trpbabos-jpg/Tech-pioneers-/bom/datenblaetter/hc-sr04_eckdaten.jpg

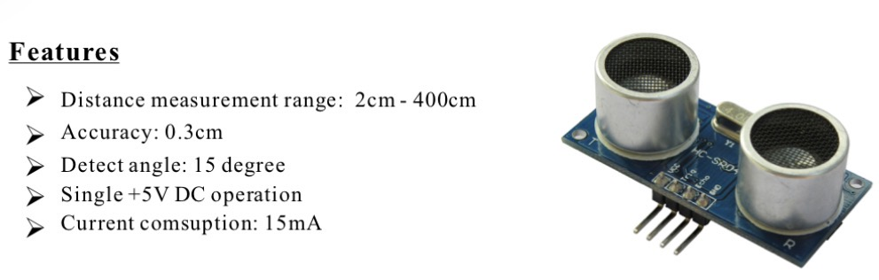
bom/datenblaetter/hc-sr04_eckdaten.jpg
