trpbabos-jpg/Tech-pioneers-/bom/datenblaetter/esp32-pico-kit-1_board.jpg

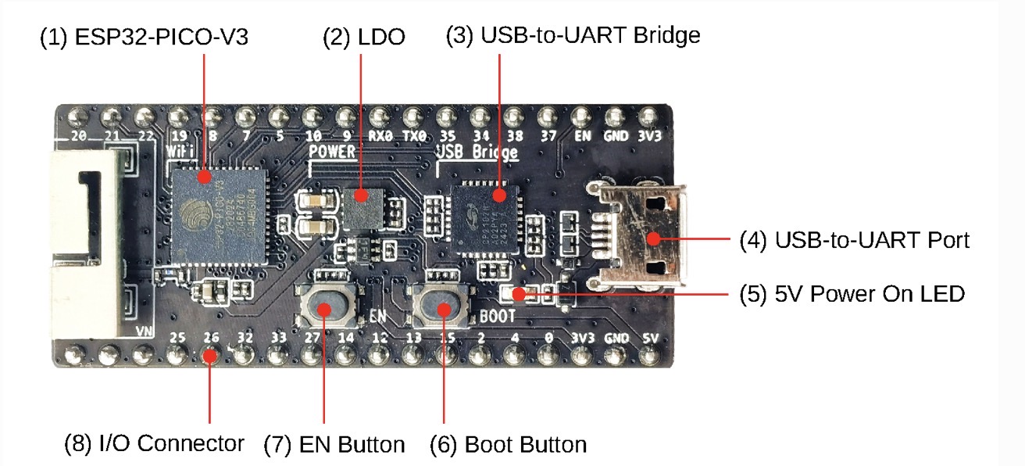
bom/datenblaetter/esp32-pico-kit-1_board.jpg
