trpbabos-jpg/Tech-pioneers-/code/README.md

# Code

MicroPython für den ESP32. Nah an den Vorlesungsfolien (Kap. 4, 4a bis 4d) 
- `main.py` ist das aktuelle Fahrprogramm, das auf dem ESP32 läuft.
- Jeder funktionierende Zwischenstand bekommt eine eigene Datei, z. B. `fahren_v5_geradeaus.py`, `fahren_v8_sanft_bremsen.py`.
