trpbabos-jpg/Tech-pioneers-/elektronik/README.md

# Elektronik

- Schaltplan (PDF oder Bild)
- Pinbelegung des ESP32 (welcher Pin ist Trigger, Echo, Motor, Encoder, Taster)

Wenn sich ein Pin ändert: Schaltplan, Pinbelegung und Code im selben Commit anpassen.

## Dateien

- `pinbelegung.md`: aktuelle Pinbelegung und frühere Stände
- `steckplan.html`: Steckplan zum Stand 29.10.2026 im Browser öffnen. Draufsicht wie auf dem Board (vorne oben), Pinübersicht und Steckliste in 8 Schritten
- `steckplan_draufsicht.png`: dieselbe Draufsicht als Bild, z. B. für Präsentationen
