trpbabos-jpg/Tech-pioneers-/doku/praesentationen/2026-11-06_weekly-closing-kw45.pdf

# Vom Frankenstein zum Batmobil

# Der Encoder hält ihn auf der Spur

Bei jedem Takt vergleicht main.py, wie viele Impulse
links und rechts gezählt wurden.

Hat links mehr, ist das linke Rad weiter gefahren. Dann bekommt links weniger Gas und rechts mehr.

Wie stark er reagiert, bestimmt KP. Bei uns sind es 0,5 % pro Impuls Unterschied.

So rechnet er

## Korrektur = 0,5 × Unterschied

Beispiel
links 110, rechts 100 Impulse
Unterschied 10 Impulse, gut 1 cm
0,5 × 10 = 5 % Korrektur
links 5 % weniger Gas, rechts 5 % mehr

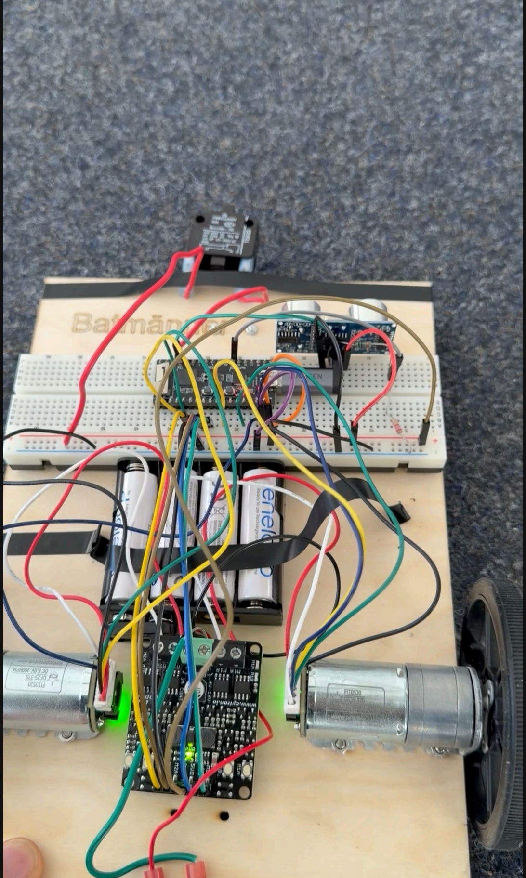
[picture p6: figure]

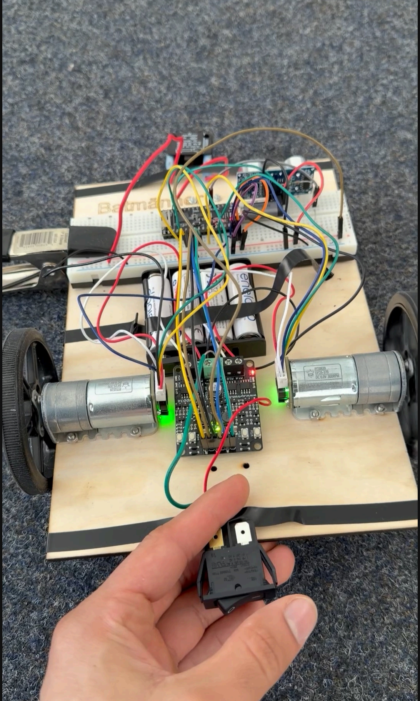
[picture p7: figure]

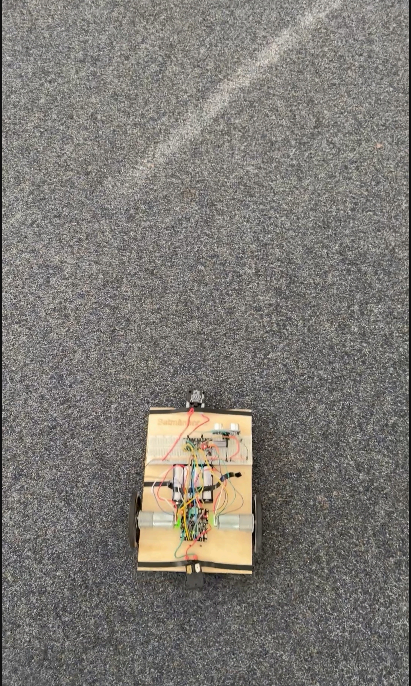
[picture p8: figure]

# Alles ausgemessen und gewogen

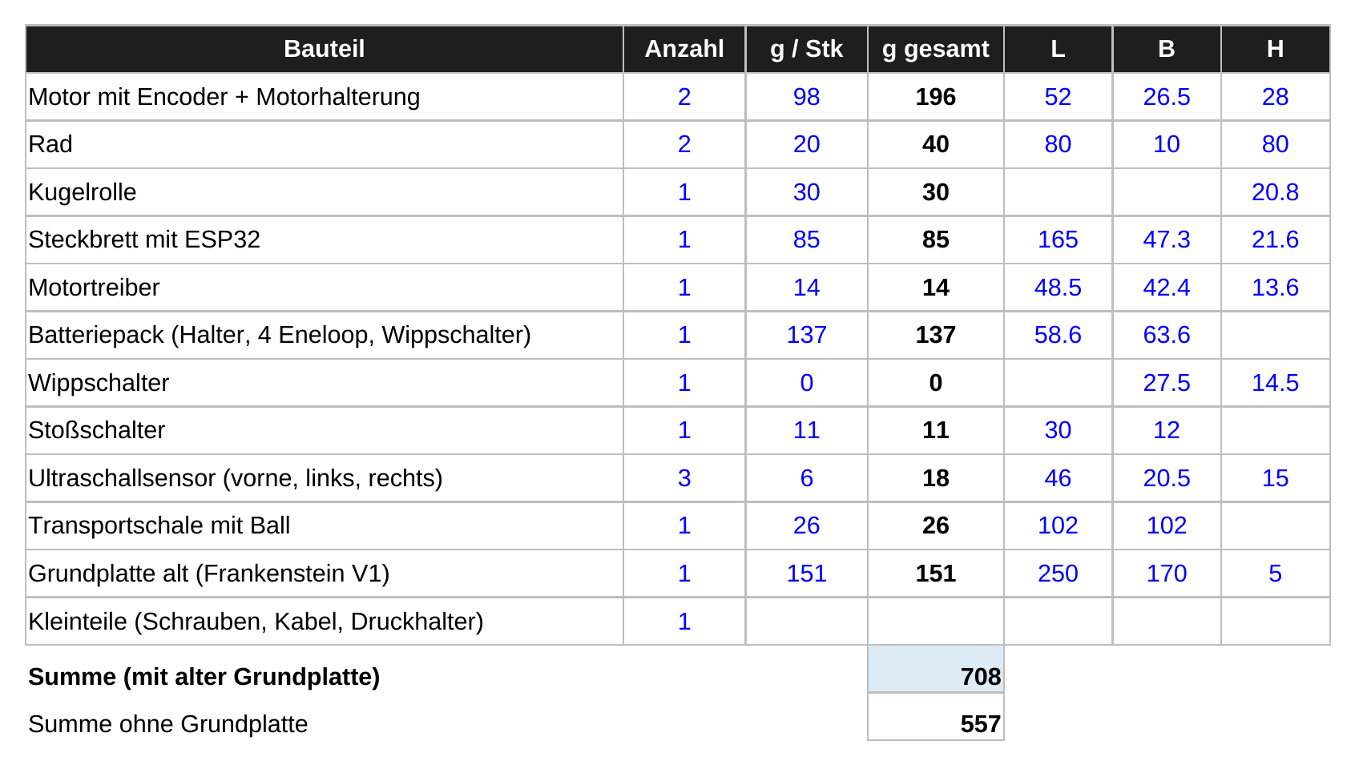
[picture p9: figure]

Ausschnitt aus unserer Excel-Tabelle, Maße in mm, Gewicht in g

Jedes Bauteil bekommt einen gedruckten Halter, der mit M3 an der Platte verschraubt wird.

Drei Ultraschallsensoren
Vorne, links und rechts, weil die Seitenwände aus Blöcken bestehen und nicht gerade sind.

# Die Schale kommt auf einen Turm

105 mm

Schalenrand über dem Boden

# 85 mm

darüber nur Podest und Schale

Um die Schale müssen 80 mm frei bleiben.

Alles andere bleibt unter 85 mm, die Räder sind 80 mm hoch.

Die Schale sitzt auf einem Turm über dem Schwerpunkt (Achse).

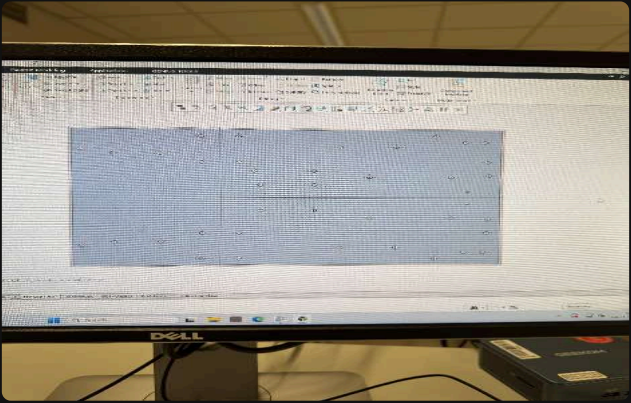
[picture p10: figure]

Caption for the image.

# Grundplatte V2

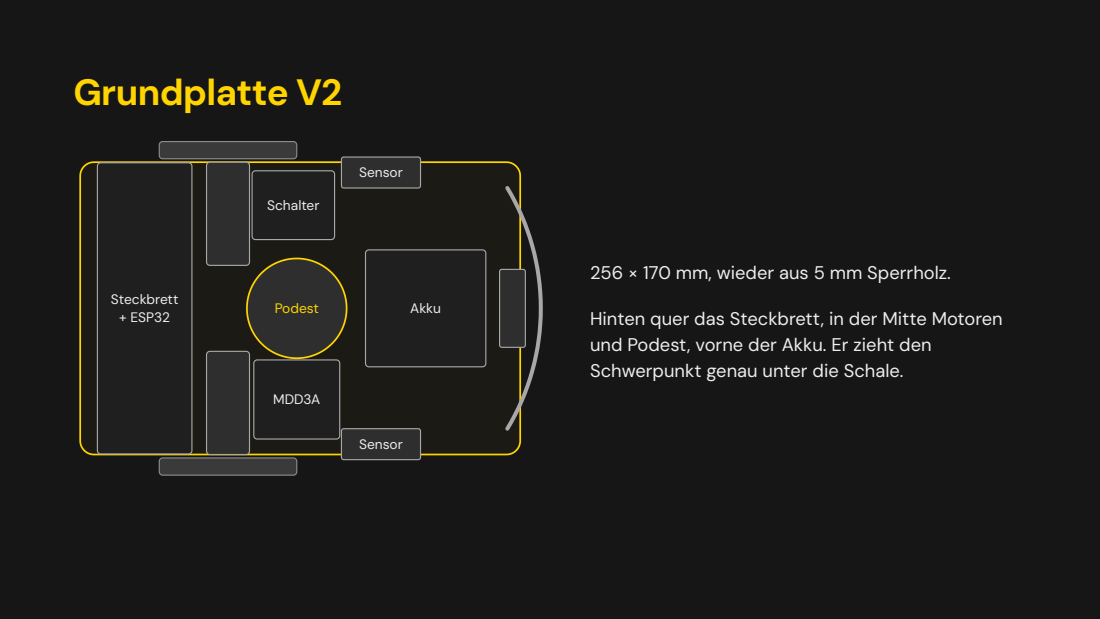
[picture p11: page 9]
Steckbrett + ESP32; Schalter; Podest; MDD3A; Akku; Sensor

256 × 170 mm, wieder aus 5 mm Sperrholz.

Hinten quer das Steckbrett, in der Mitte Motoren
und Podest, vorne der Akku. Er zieht den
Schwerpunkt genau unter die Schale.

# Aus dem Chassis wird ein Batmobil

# 85 mm

Flach und breit, so wie ein Batmobil sowieso aussieht.

Die Kapseln der Ultraschallsensoren schauen durch Löcher heraus, wie Waffen.

# Nächste Woche

## Den Ball auf dem Roboter testen sowie den Code anpassen Grundplatte V2 in Creo zu Ende zeichnen und lasern Die Komponenten auf die neue Grundplatte anbringen Kanban Board erstellen
