trpbabos-jpg/Tech-pioneers-/doku/praesentationen/2026-10-16_pitch.pdf

Study Bootcamp Technik, TechPioneers, WS 2026/27

# Mobiler Roboter für den Wall-Sprint

## Pitch: Bauteile und erste Ideen

Was er können muss
200 cm geradeaus fahren
kontrolliert und sanft vor der Wand anhalten dabei so schnell wie möglich sein

# Steuerung: ESP32-PICO-KIT-1


Chip | ESP32-PICO-V3, 2 Kerne, 240 MHz
Funk | WLAN und Bluetooth eingebaut
Versorgung | USB, 5V-Pin oder 3V3-Pin, immer nur eine Quelle
Pins | 3,3 V, höchstens 3,6 V
Nur Eingang | GPIO 34 bis 39

Quellen: Espressif, ESP32-PICO-KIT-1 User Guide; ESP32-PICO Datenblatt, Kap. 5.2 bis 5.4

# Antrieb: DFRobot FIT0520 mit Encoder

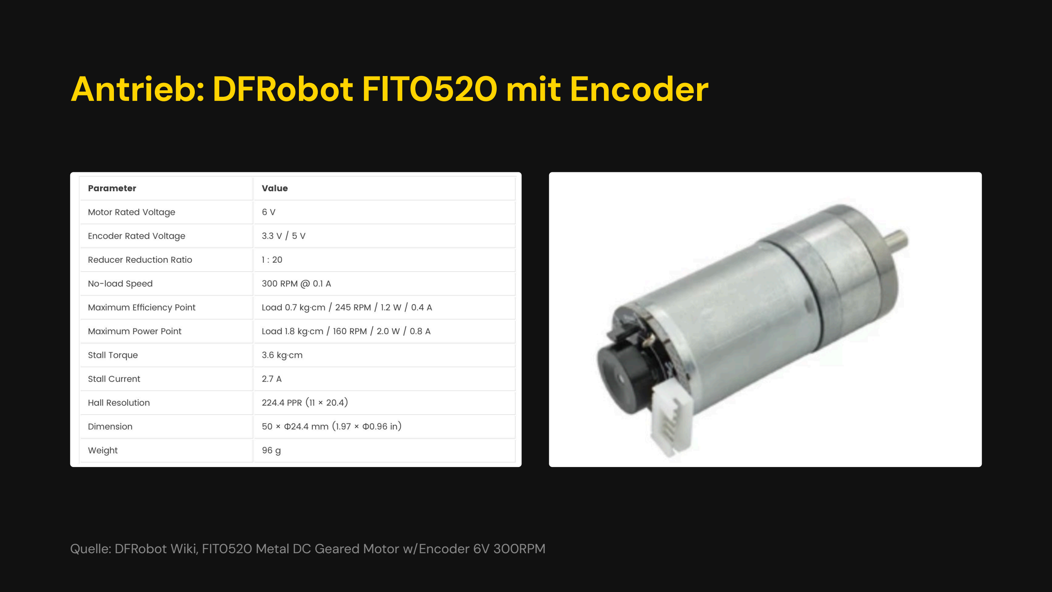
[picture p12: page 3]

Quelle: DFRobot Wiki, FIT0520 Metal DC Geared Motor w/Encoder 6V 300RPM

# Motortreiber: Cytron MDD3A

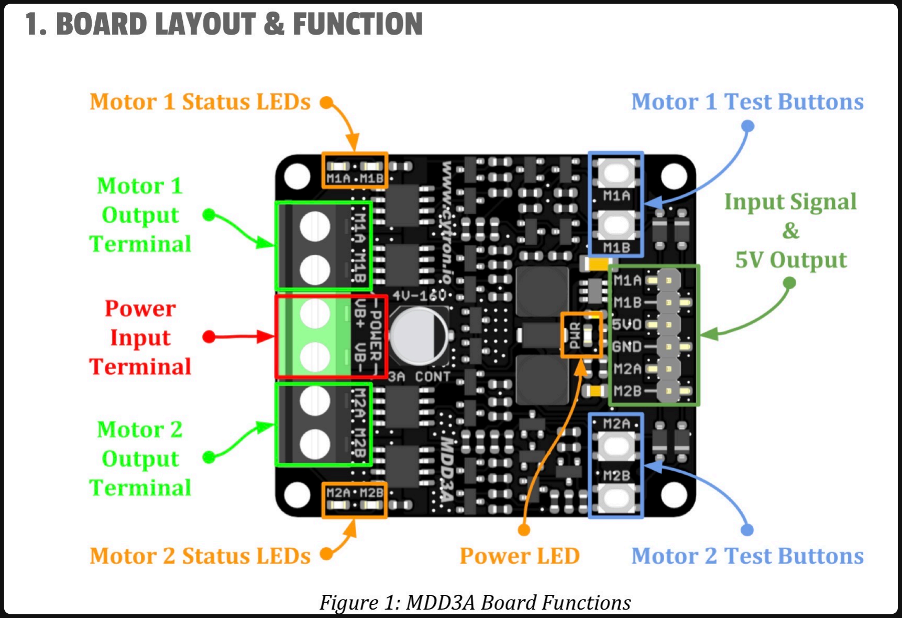
[picture p13: figure]

Spannung | 4 bis 16 V
Strom | 3 A dauerhaft, 5 A unter 5 s
Eingänge | ab 1,7 V high, 3,3 V reichen
PWM | bis 20 kHz
Bremsen | wenn beide Eingänge gleich sind
5-V-Ausgang | höchstens 200 mA
Extra | Testtaster für jeden Motor

Quelle: Cytron, MDD3A Datenblatt (Spezifikation und Wahrheitstabelle)

# Abstand: Ultraschallsensor HC-SR04

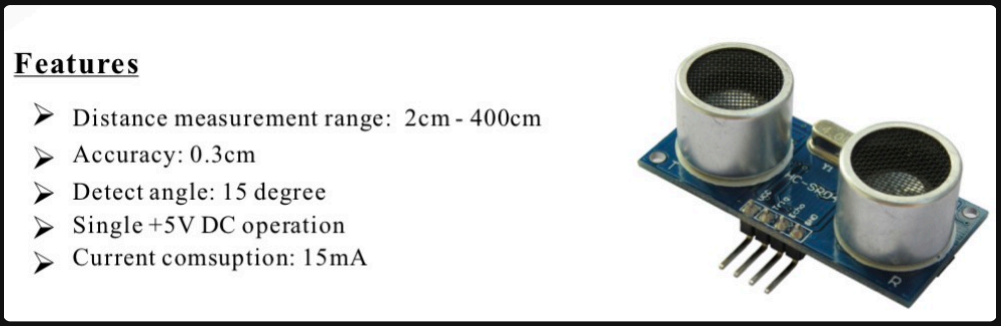
[picture p14: figure]

Quelle: HC-SR04 Datenblatt (ElecFreaks), Bilder aus dem Datenblatt

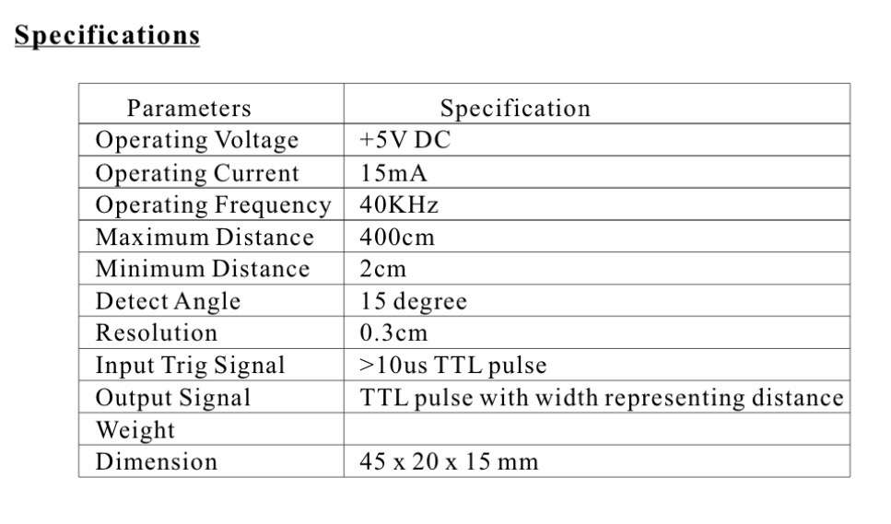
[picture p15: figure]

# Energie: 4 Eneloop-Akkus BK-3MCDE

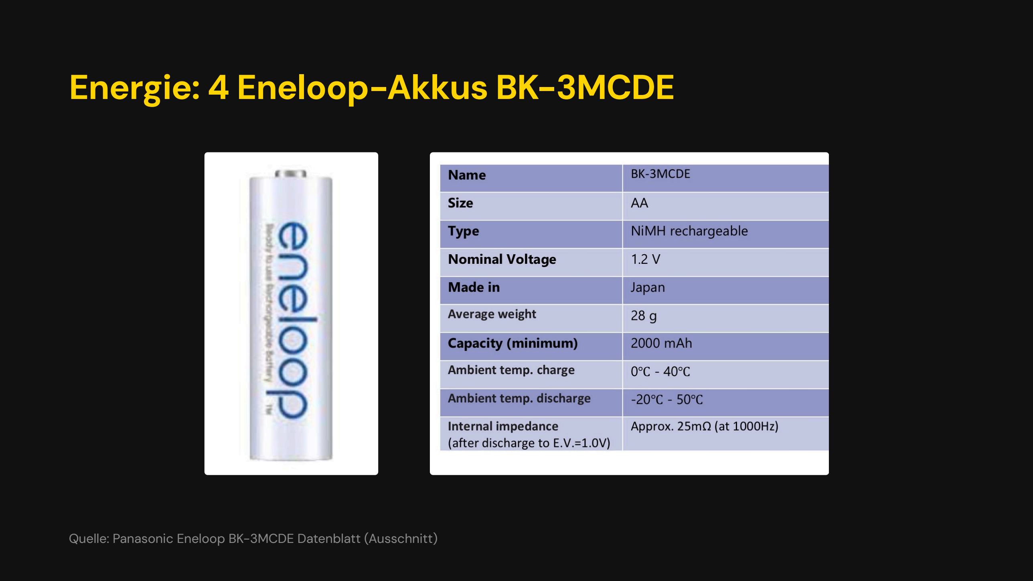
[picture p16: page 6]

Quelle: Panasonic Eneloop BK-3MCDE Datenblatt (Ausschnitt)

# Rechnungen

Was | Rechnung | Ergebnis
Drehzahl bei 4,8 V | 245 U/min × 4,8 V ÷ 6 V | ≈ 196 U/min
Radumfang | π × 80 mm | ≈ 251 mm
Geschwindigkeit | 196 ÷ 60 s × 0,251 m | ≈ 0,82 m/s
Fahrzeit bei vollem Tempo | 2,0 m ÷ 0,82 m/s | ≈ 2,4 s

Werte aus den Datenblättern: DFRobot FIT0520 (245 U/min bei 6 V, 224,4 Impulse) und Eneloop BK-3MCDE (1,2 V pro Zelle)

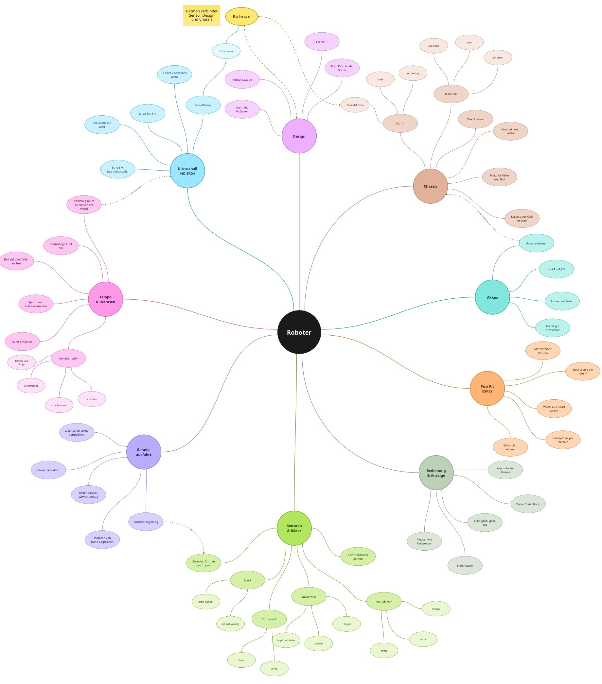
[picture p17: figure]

# Mind Map

Ast
Querverbindung zwischen zwei Ästen

Wichtige Querverbindungen
Bremsbeginn → Ultraschall: erkennt die Wand Encoder-Regelung → Encoder: nutzt die Impulse Akkus unten → Chassis: tiefer Schwerpunkt Batman → Design und Chassis

# Warum der Name Batman

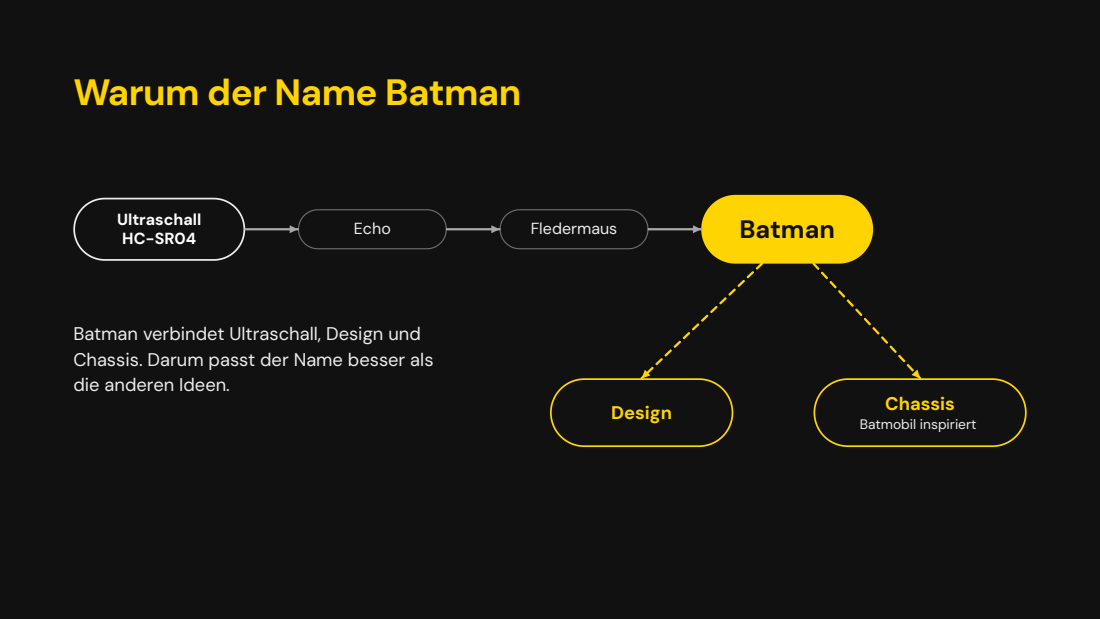
[picture p18: page 9]
Ultraschall HC-SR04; Echo; Fledermaus; Batman; Design; Chassis Batmobil inspiriert

Batman verbindet Ultraschall, Design und
Chassis. Darum passt der Name besser als
die anderen Ideen.

# Offene Fragen

Frage | Ideen aus der Mind Map
Geradeausfahrt | Encoder-Regelung,, zwei Sensoren vorne vergleichen, Ultraschall seitlich mit Bande als Hilfe
Anhalten | aktiv bremsen, Rollen
Wand erkennen | ein oder zwei Ultraschallsensoren vorne, Strecke über die Encoder zählen
Antrieb und Stütze | Antrieb vorne, hinten oder mittig, eine Kugel, zwei Roller oder beides
Chassis | rund oder rechteckig, Sperrholz, Acryl oder 3D-Druck
Bedienung | Taster Start/Stopp, LEDs, Piepser, Start per Handy über WLAN
Name und Look | Batman
