trpbabos-jpg/Tech-pioneers-/fotos/README.md

# Fotos

Fotos vom Aufbau nach jedem wichtigen Schritt und von Tests. Dateiname mit Datum, z. B. `2026-11-12_grundplatte_v2_montiert.jpg`.

Zusammengehörige Bilder kommen in einen Unterordner mit Datum und Thema, z. B. `2026-11-13_cad_baugruppe/` für die Screenshots der Creo-Baugruppe.
