trpbabos-jpg/Tech-pioneers-/doku/mindmap_v1.pdf

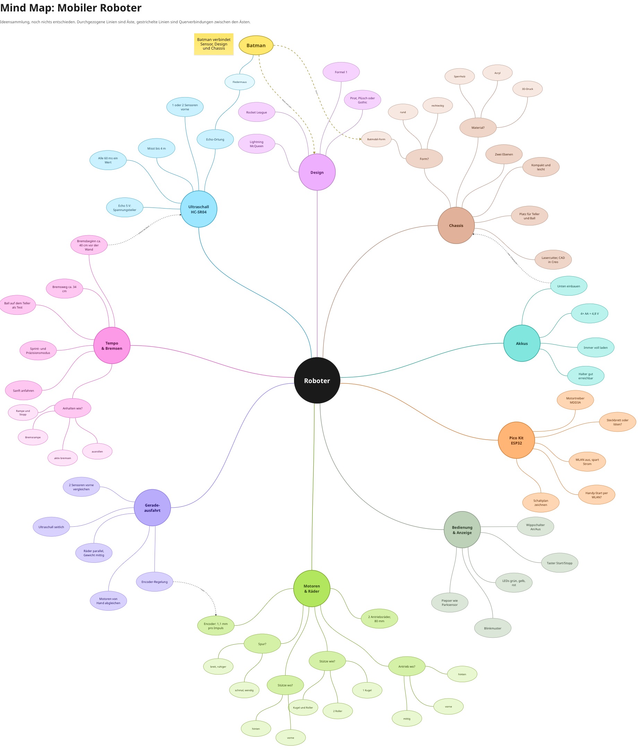
[picture p19: page 1]
