trpbabos-jpg/Tech-pioneers-/cad/skizzen/2026-10-16_echo_form_draufsicht.png

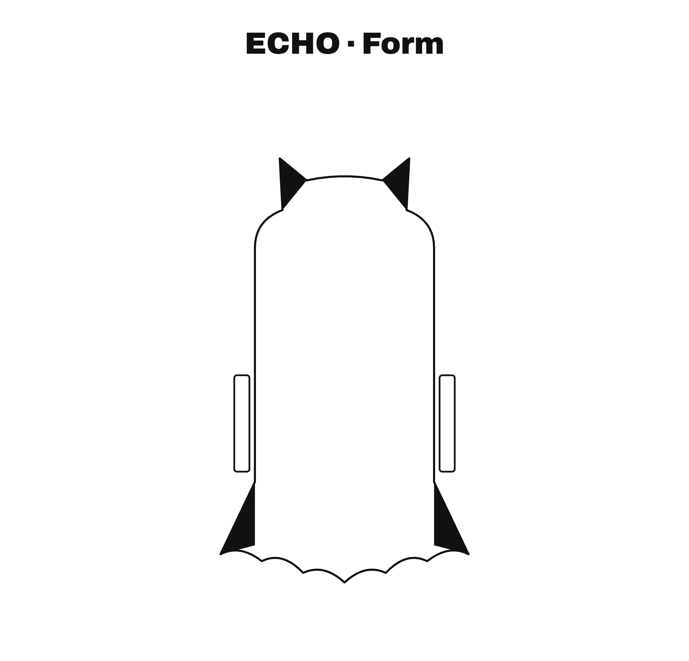
cad/skizzen/2026-10-16_echo_form_draufsicht.png
