trpbabos-jpg/Tech-pioneers-/cad/skizzen/2026-11-11_podest_schnitt.png

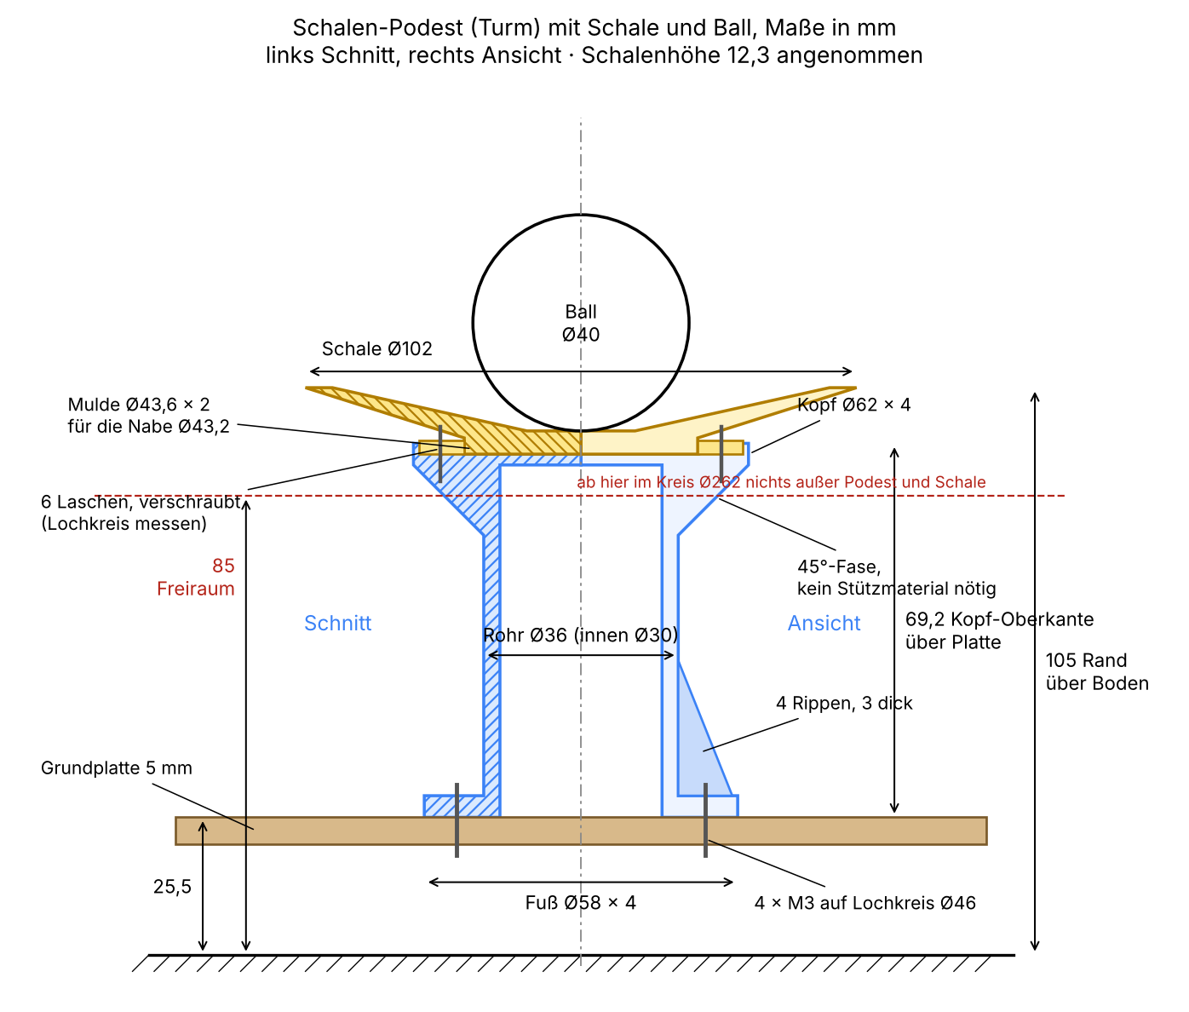
cad/skizzen/2026-11-11_podest_schnitt.png
