trpbabos-jpg/Tech-pioneers-/elektronik/steckplan_draufsicht.png

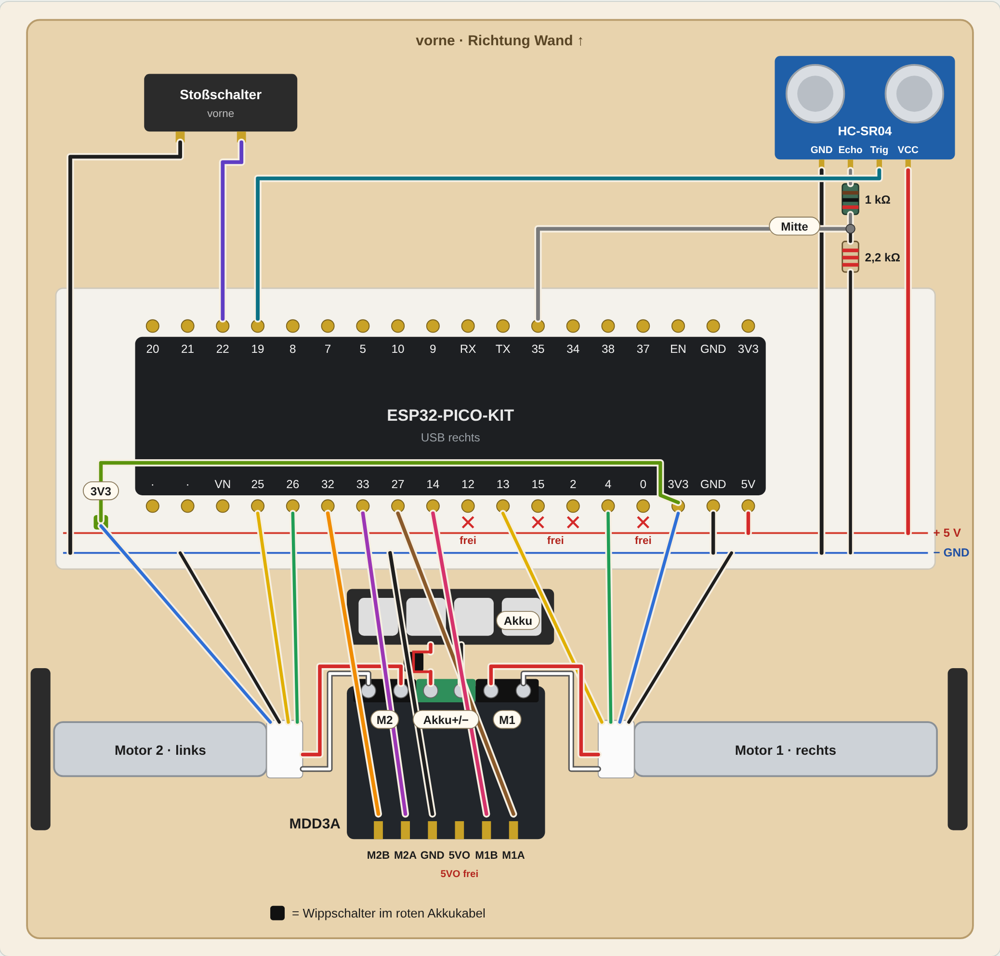
elektronik/steckplan_draufsicht.png
