trpbabos-jpg/Tech-pioneers-/fotos/2026-11-09_grundplatte_v2_draufsicht.jpg

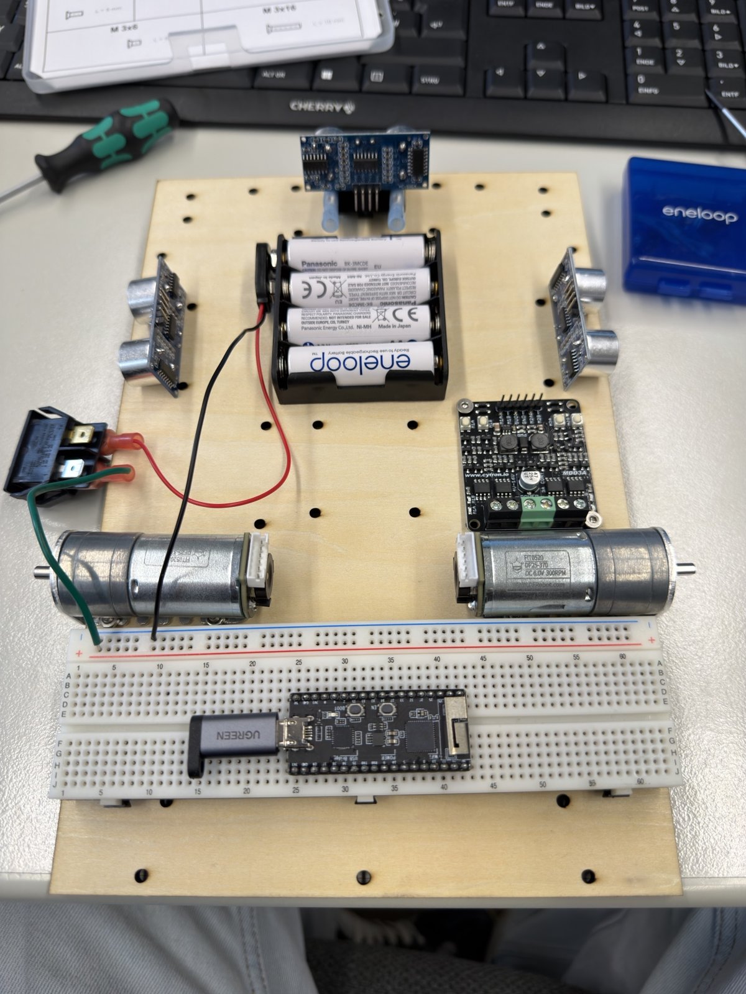
fotos/2026-11-09_grundplatte_v2_draufsicht.jpg
