trpbabos-jpg/Tech-pioneers-/fotos/2026-11-09_stossschalter_kippt.jpg

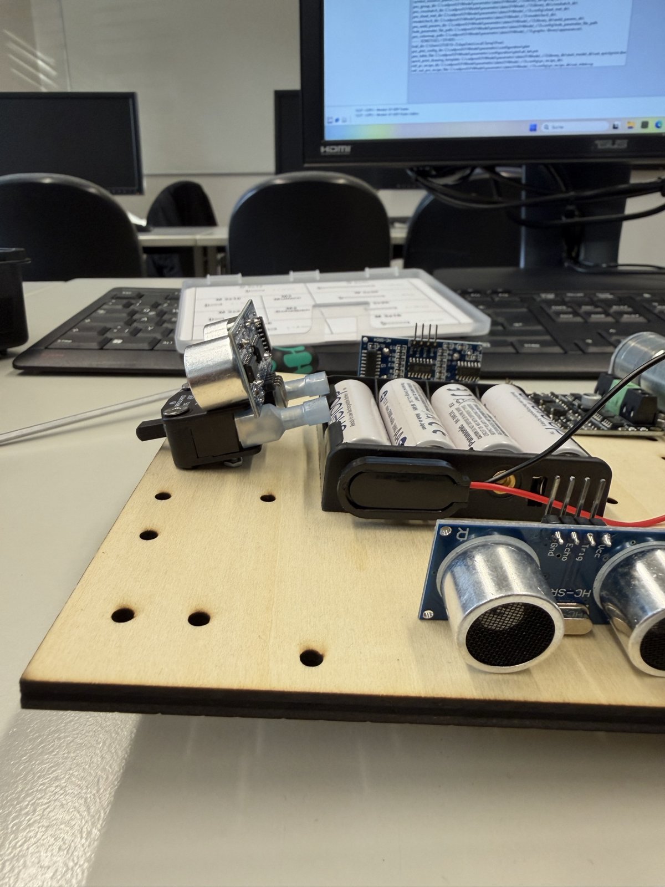
fotos/2026-11-09_stossschalter_kippt.jpg
