trpbabos-jpg/Tech-pioneers-/fotos/2026-11-09_stossschalter_unterlegt.jpg

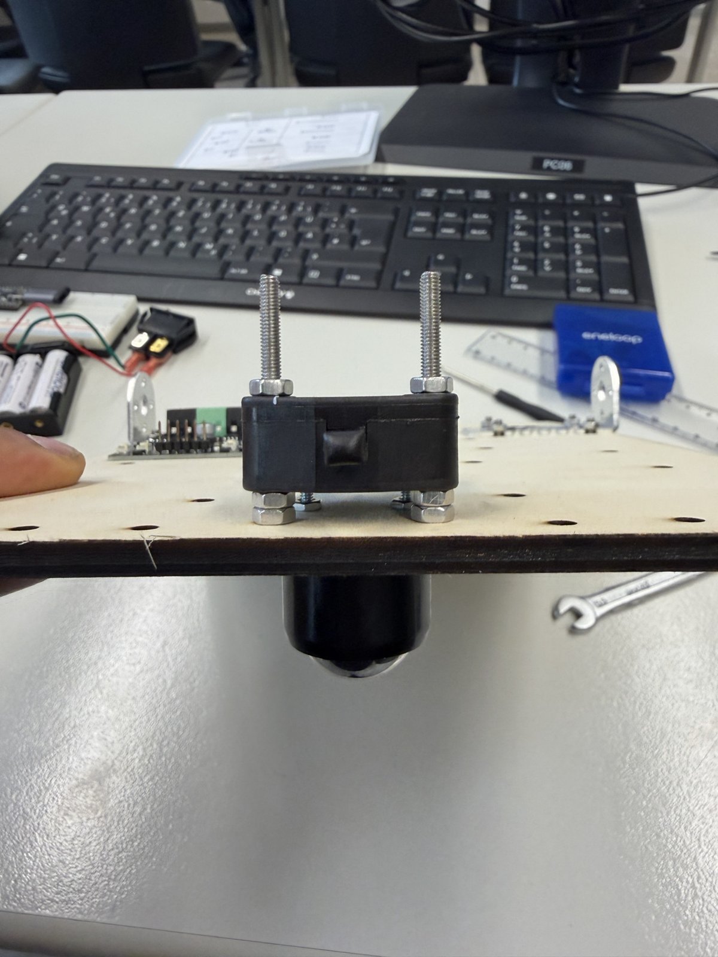
fotos/2026-11-09_stossschalter_unterlegt.jpg
