trpbabos-jpg/Tech-pioneers-/fotos/2026-11-13_cad_baugruppe/baugruppe_schraeg_links.png

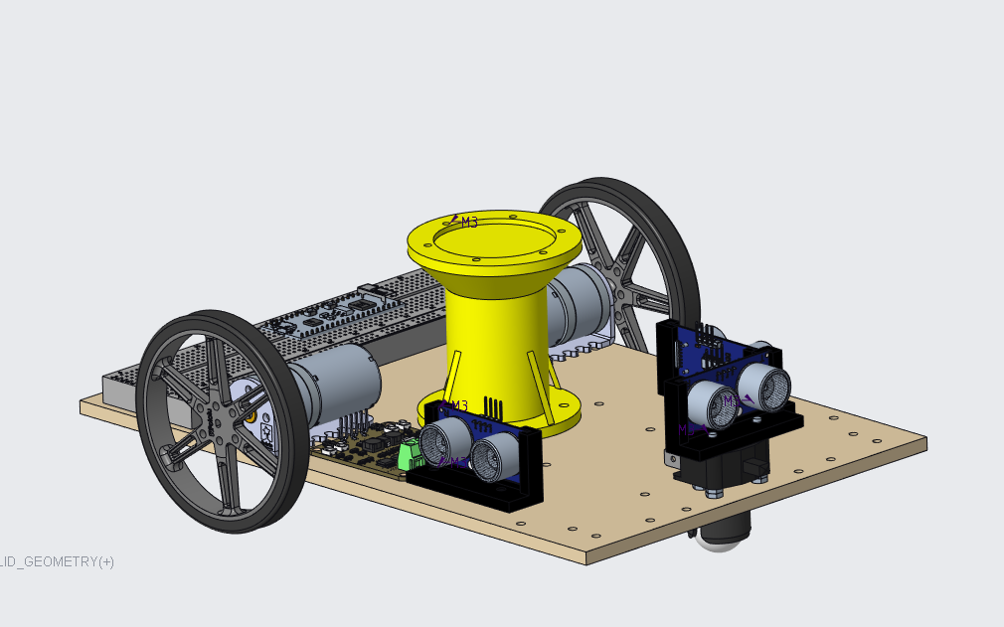
fotos/2026-11-13_cad_baugruppe/baugruppe_schraeg_links.png
