trpbabos-jpg/Tech-pioneers-/fotos/2026-11-13_elektronik_verkabelt.jpg

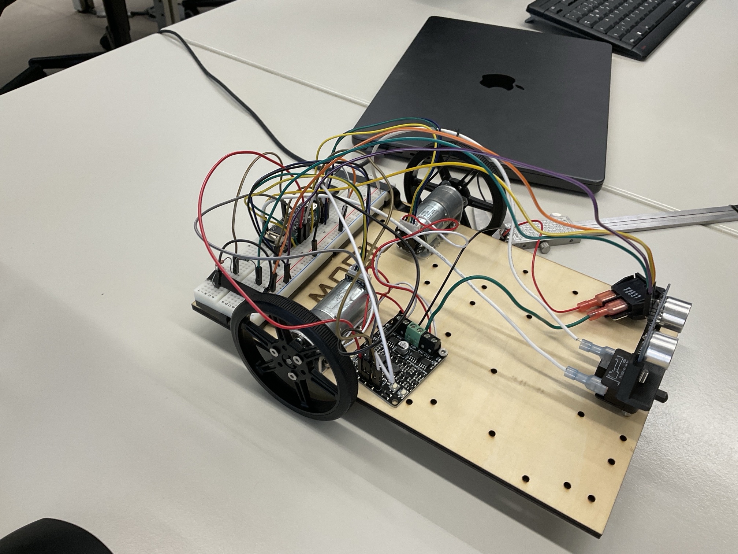
fotos/2026-11-13_elektronik_verkabelt.jpg
