trpbabos-jpg/Tech-pioneers-/fotos/starterkit_inhalt_seite1.jpg

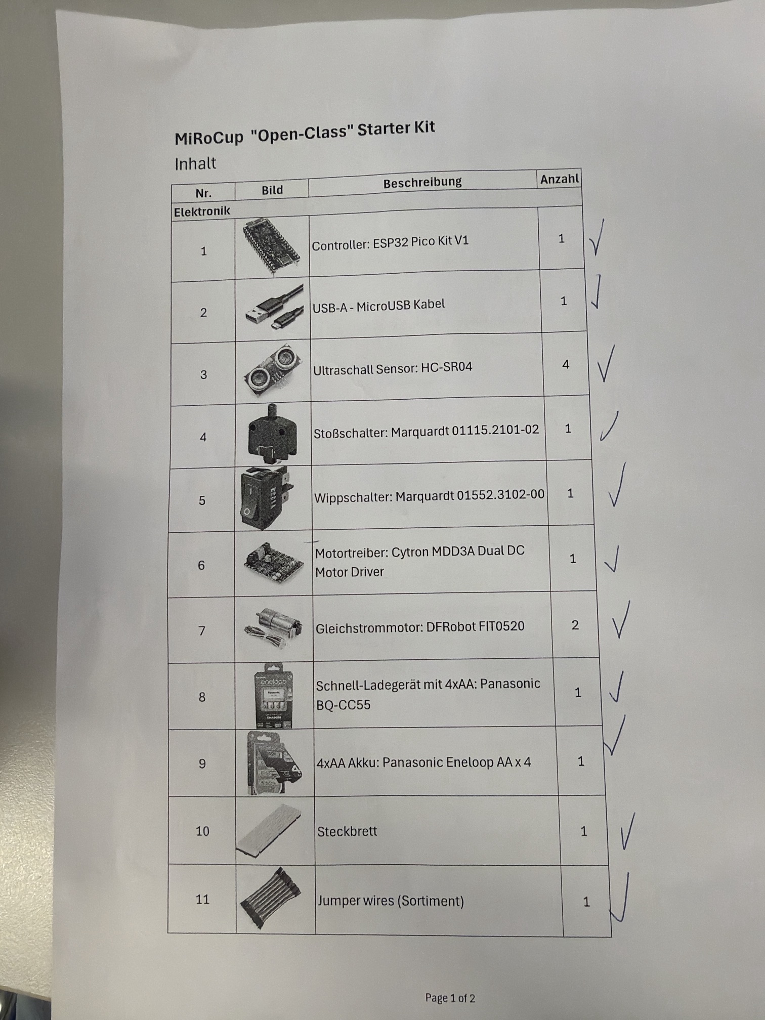
fotos/starterkit_inhalt_seite1.jpg
