trpbabos-jpg/Tech-pioneers-/fotos/starterkit_inhalt_seite2.jpg

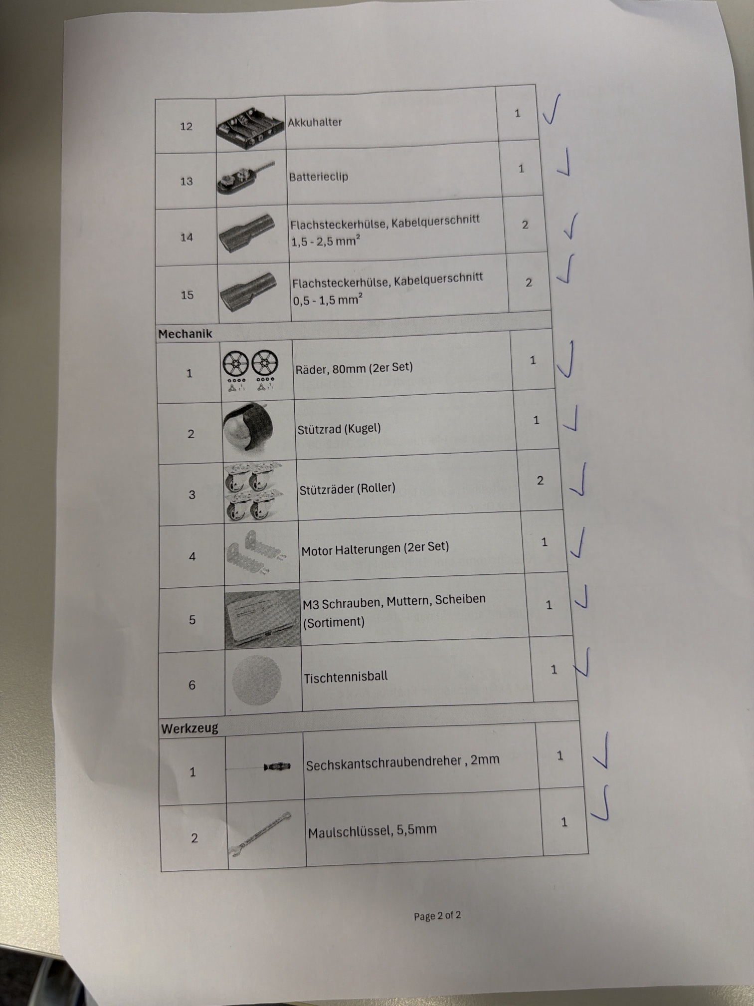
fotos/starterkit_inhalt_seite2.jpg
