trpbabos-jpg/Tech-pioneers-/bom/materialliste.md

# Materialliste (BOM)

Alle Bauteile des Roboters. „Anzahl im Kit“ ist der Inhalt des MiRoCup Starter Kits (Fotos in `fotos/starterkit_inhalt_seite1.jpg` und `seite2.jpg`), „Verbaut“ ist das, was am Roboter sitzt. Ein ? heißt: noch zählen und eintragen.

| Bauteil | Anzahl im Kit | Verbaut | Herkunft | Bemerkung |
| --- | --- | --- | --- | --- |
| Controller ESP32-PICO-KIT V1 | 1 | 1 | Starter Kit | Chip ESP32-PICO-V3, GPIO18 und 23 nicht herausgeführt |
| USB-A auf Micro-USB Kabel | 1 | 0 | Starter Kit | nur zum Programmieren |
| Ultraschallsensor HC-SR04 | 4 | 3 | Starter Kit | vorne, links, rechts, Echo jeweils über Spannungsteiler 1 kOhm / 2,2 kOhm |
| Stoßschalter Marquardt 01115.2101-02 | 1 | 1 | Starter Kit | vorne, erkennt die Wand |
| Wippschalter Marquardt 01552.3102-00 | 1 | 1 | Starter Kit | Hauptschalter zwischen Akku und MDD3A, gleichzeitig Start |
| Motortreiber Cytron MDD3A | 1 | 1 | Starter Kit | 4 x M3 mit Abstandshülsen 5 mm direkt auf der Platte |
| Gleichstrommotor DFRobot FIT0520 mit Encoder | 2 | 2 | Starter Kit | 224 Impulse pro Radumdrehung |
| Schnell-Ladegerät Panasonic BQ-CC55 | 1 | 0 | Starter Kit |  |
| Akku Panasonic Eneloop AA | 4 | 4 | Starter Kit | zusammen ca. 4,8 V |
| Steckbrett | 1 | 1 | Starter Kit | in gedruckter Wanne hinten |
| Jumperkabel (Sortiment) | 1 | ? | Starter Kit |  |
| Akkuhalter | 1 | 1 | Starter Kit | vorne als Trimmgewicht |
| Batterieclip | 1 | 1 | Starter Kit |  |
| Flachsteckerhülse 1,5 bis 2,5 mm² | 2 | ? | Starter Kit |  |
| Flachsteckerhülse 0,5 bis 1,5 mm² | 2 | ? | Starter Kit |  |
| Räder 80 mm (2er Set) | 1 | 1 | Starter Kit |  |
| Stützrad (Kugel) | 1 | 1 | Starter Kit | vorne, 2 x M2 |
| Stützräder (Roller) | 2 | 0 | Starter Kit | nicht verwendet |
| Motorhalterungen (2er Set) | 1 | 1 | Starter Kit |  |
| M3 Schrauben, Muttern, Scheiben (Sortiment) | 1 | ? | Starter Kit | Stückzahlen eintragen |
| Tischtennisball | 1 | 1 | Starter Kit | liegt in der Schale |
| Widerstand 1 kOhm |  | 3 | Labor | Spannungsteiler oben, einer pro Ultraschallsensor |
| Widerstand 2,2 kOhm |  | 3 | Labor | Spannungsteiler unten, einer pro Ultraschallsensor |
| Sperrholzplatte 5 mm |  | 1 | Labor | 256 x 170 mm, gelasert |
| 3D-Druckteile (Podest, Haube, Steckbrett-Wanne, Halterungen) |  | ? | 3D-Drucker | STL im Ordner cad |
| Gewindeeinsatz M3 |  | 7 | zusätzlich | für die Haube |
| Abstandshülse M3 5 mm |  | 4 | zusätzlich | für den MDD3A |
| Schraube M2 |  | 2 | zusätzlich | Stützrad |
| Schale für den Ball |  | 1 | ? | Ø 102 mm, Herkunft prüfen |

Maße, Gewichte und Lage der Bauteile auf der Grundplatte v2 stehen in `Grundplatte_Masse_Gewicht_V2.xlsx`.
