trpbabos-jpg/Tech-pioneers-/bom/Grundplatte_Masse_Gewicht_V2.xlsx

Sheet: Bauteile
Neue Grundplatte: Bauteile, Maße, Gewicht
Maße in mm, Gewicht in g. Blau = eingetragener Wert, schwarz = Formel. L = in Fahrtrichtung bzw. lange Seite.
Bauteil | Modell | Anzahl | g / Stk | g gesamt | L | B | H | Befestigung / Lochbild | Quelle und Abgleich | Status | Noch messen
Motor mit Encoder + Motorhalterung | DFRobot FIT0520 + Pololu #2676 | 2 | 98 | 196 | 52 | 26.5 | 28 | Winkel an den Randkerben, M3. Kerbenraster 6,35, Abstand der Kerbreihen 21,7. Achse 14,5 über Winkelunterseite. | Gewogen 90 + 8 g (online 96 + 8,5 g). Winkel gemessen 25,3 breit, Flansch 26,6 hoch (Pololu 25 und 27). Motor Ø24,4, mit Winkel ca. 1 bis 2 mm größer. | gemessen + online | Wo Encoder und Kabel hinten herausstehen (Länge gesamt).
Rad | Pololu Multi-Hub 80 × 10 mm (#3690) | 2 | 20 | 40 | 80 | 10 | 80 | Klemmhülse 4 mm D, 3 × M3 × 7. Hülse + Platte ca. 6 mm dick. | Gewogen 20 g (Pololu 23 g). Ø80, Reifen 10 mm laut Pololu. | gemessen + online | Breite über die Nabe, Spurweite am Roboter.
Kugelrolle | Pololu #955, 3/4″ Metallkugel | 1 | 30 | 30 |  |  | 20.8 | 2 Schrauben #2 oder M2 (keine M3), Lochabstand 15,5, Bohrung 2,5, ohne Spacer. Bei V1 mittig bei Y 224. | An der V1-Platte (Zeichnung V1.2) verbaut und passt. Gewogen 30 g = Pololu 30 g. Höhe 20,8 ohne Spacer laut Pololu. | gemessen + online
Steckbrett mit ESP32 | 830er, eine Stromschiene abgenommen, schwarze Bodenplatte mit Füßen | 1 | 85 | 85 | 165 | 47.3 | 21.6 | 3D-Druckhalter. Achtung: An einer Längsseite stehen 3 Nasen (Schwalbenschwanz) ca. 2 mm über, an der kurzen Seite eine kleine schwarze Nase. Im Halter dort Aussparungen oder 3 mm Luft lassen. Der USB-Adapter liegt auf dem Steckbrett, über dem ESP32 also Platz nach oben lassen. | Länge 165 (Normmaß 165,1). Breite 47,3 ohne Nasen, Höhe 21,6 mit Messschieber (Oberkante bis Füße). ESP32 52 × 20,3 laut Espressif. | gemessen + online | Wie weit die Nasen genau überstehen und wo sie sitzen (Abstand von der Ecke).
Motortreiber | Cytron MDD3A | 1 | 14 | 14 | 48.5 | 42.4 | 13.6 | 4 × M3 auf 3D-Druck-Abstandshaltern. Lochabstand quer ca. 37 (Messschieber 40 über Außenkanten minus Loch-Ø), längs ca. 42 (nur aus Foto). | Gewogen 14 g = online 14 g. Gemessen 48,5 × 42,4, online 48 × 42. Höhe 13,6 online. Lochbild steht online nur als Bild. | gemessen + online | Lochabstand längs und Loch-Ø mit Messschieber, Höhe der Lötstellen unten.
Batteriepack (Halter, 4 Eneloop, Wippschalter) | 4 × AA nebeneinander | 1 | 137 | 137 | 58.6 | 63.6 |  | 3D-Druckhalter. Mit Batterie-Clip 65,3 lang. Kabel kommt am Clip heraus. | Gemessen 63,6 × 58,6. Passt zu 4 × Ø14,5 (Eneloop) plus Wände. Gewogen 137 g, online wären allein die Akkus 4 × 27 = 108 g. | gemessen + online | Höhe.
Wippschalter | Marquardt 1552 | 1 | 0 | 0 |  | 27.5 | 14.5 | Ausschnitt 27,2 × 12,2 in einer Wand von 0,8 bis 5 mm (Druckteil). | Rahmen gemessen ca. 27,5 × 14,5, online Ausschnitt 27,2 × 12,2. Gewicht steckt im Batteriepack. | gemessen + online
Stoßschalter | Marquardt 1115 | 1 | 11 | 11 | 30 | 12 |  | 2 × M3, Lochabstand ca. 22,2 (25,4 über Außenkanten minus Loch-Ø 3,1). | Gemessen ca. 30 breit mit Laschen, ca. 12 dick. 22,2 ist das Normmaß für Standard-Mikroschalter. | gemessen + online
Ultraschallsensor (vorne, links, rechts) | HC-SR04 | 3 | 6 | 18 | 46 | 20.5 | 15 | 4 Eckbohrungen ca. Ø1,5 im Abstand ca. 42 × 17 (aus Foto): zu klein für M3. Halter mit Druckstiften Ø1,3 oder Schrauben M1,4; Halter selbst mit M3 auf die Platte. Stiftleiste ragt 6,8 seitlich über, mit Stecker mehr Platz lassen. Seitensensoren tief, Mitte 4 bis 6 cm über Boden. | Gemessen 46 × 20,5, mit Stiften 26,8. Höhe Kapsel bis Unterseite der blauen Platine 15,2, bis zu den Metallstiften hinten 17,5 (Datenblatt 45 × 20 × 15). Kapsel steht also ca. 13,6 über der Platine (Platine ca. 1,6 dick). Über beide Kapseln außen 42,1, Kapsel-Ø ca. 16 (üblicher Wert), also Kapselmitten ca. 26 auseinander. Loch-Ø ca. 1,5. Gewogen 6 g. | gemessen + online | Kapsel-Ø einmal direkt messen, falls der Halter eng sitzen soll.
Transportschale mit Ball | vom Veranstalter, Ball 40 mm | 1 | 26 | 26 | 102 | 102 |  | Nabe Ø43,2 mit 6 Laschen zum Verschrauben. | Gemessen Ø ca. 102 am Rand, Nabe 43,2. Gewogen 26 g. | gemessen | Lochkreis und Loch-Ø der Laschen, Gesamthöhe.
Grundplatte alt (Frankenstein V1) | Sperrholz 5 mm | 1 | 151 | 151 | 250 | 170 | 5 | Motoren oben auf der Platte. | Gewogen 151 g. Ergibt 0,36 g pro cm². | gemessen
Kleinteile (Schrauben, Kabel, Druckhalter) |  | 1 |  |  |  |  |  |  |  | offen | Zum Schluss den ganzen Roboter wiegen.
Summe (mit alter Grundplatte) |  |  |  | 708
Summe ohne Grundplatte |  |  |  | 557

Sheet: Lage V2
Grundplatte V2: Lage aller Bauteile und Freiraum-Prüfung
Ursprung = Mitte Radachse auf Plattenoberseite, x nach vorne, y nach links, z nach oben. Maße in mm, Masse in g. Blau = eingetragener Wert, grün = Verweis auf ein anderes Blatt, schwarz = Formel. Jedes Bauteil als Quader (von/bis).
Schalenmitte x | 40.0 | mm | über den Schwerpunkt gelegt (Blatt Schwerpunkt V2)
Schalenmitte y | 0.0 | mm | mittig
Schalenrand über Boden | 105.0 | mm | Räder 80 + 20 Regelabstand + 5 Reserve
Plattenoberseite über Boden | 25.5 | mm | aus Blatt Grenzen: Achse 40 minus 14,5
Freiraum-Radius um die Schalenmitte | 131.0 | mm | Ø262 aus Blatt Grenzen
Freiraum gilt ab (über Boden) | 85.0 | mm | Regel 4: ab 20 mm unter dem Rand nach oben
Nr | Bauteil | Masse g | x von | x bis | y von | y bis | z von | z bis | x Mitte | y Mitte | z Mitte | z Mitte über Boden | Oberkante über Boden | Abstand zur Schalenachse | Freiraum prüfen? | Freiraum | Quelle Masse / Hinweis
1 | Grundplatte Sperrholz 5 mm | 154.4 | -86.0 | 170.0 | -85.0 | 85.0 | -5.0 | 0.0 | 42.0 | 0.0 | -2.5 | 23.0 | 25.5 | 0.0 | ja | OK, 59.5 mm Luft | berechnet aus 0,355 g/cm² (alte Platte)
2 | Motor + Winkel links | 98.0 | -12.5 | 12.5 | 18.0 | 85.0 | 0.0 | 27.0 | 0.0 | 51.5 | 13.5 | 39.0 | 52.5 | 32.9 | ja | OK, 32.5 mm Luft | gewogen 90 + 8 g
3 | Motor + Winkel rechts | 98.0 | -12.5 | 12.5 | -85.0 | -18.0 | 0.0 | 27.0 | 0.0 | -51.5 | 13.5 | 39.0 | 52.5 | 32.9 | ja | OK, 32.5 mm Luft | gewogen 90 + 8 g
4 | Rad links | 20.0 | -40.0 | 40.0 | 87.0 | 97.0 | -25.5 | 54.5 | 0.0 | 92.0 | 14.5 | 40.0 | 80.0 | 87.0 | ja | OK, 5.0 mm Luft | gewogen 20 g, Spurweite angenommen
5 | Rad rechts | 20.0 | -40.0 | 40.0 | -97.0 | -87.0 | -25.5 | 54.5 | 0.0 | -92.0 | 14.5 | 40.0 | 80.0 | 87.0 | ja | OK, 5.0 mm Luft | gewogen 20 g, Spurweite angenommen
6 | Steckbrett mit ESP32 | 85.0 | -73.6 | -26.3 | -82.5 | 82.5 | 2.0 | 23.6 | -50.0 | 0.0 | 12.8 | 38.3 | 49.1 | 66.3 | ja | OK, 35.9 mm Luft | gewogen 85 g
7 | ESP32 und Kabel über Steckbrett | 0.0 | -60.0 | -40.0 | -30.0 | 30.0 | 23.6 | 50.0 | -50.0 | 0.0 | 36.8 | 62.3 | 75.5 | 80.0 | ja | OK, 9.5 mm Luft | Platzhalter für ESP32 und Kabel, max. 25 mm über dem Steckbrett
8 | Steckbrett-Wanne (Druck) | 18.0 | -76.0 | -21.1 | -84.8 | 84.8 | 0.0 | 8.0 | -48.5 | 0.0 | 4.0 | 29.5 | 33.5 | 61.1 | ja | OK, 51.5 mm Luft | geschätzt, PLA 20 % Füllung
9 | Akku-Pack 4 × AA (Wanne) | 137.0 | 79.6 | 144.9 | -31.8 | 31.8 | 2.0 | 20.0 | 112.2 | 0.0 | 11.0 | 36.5 | 45.5 | 39.6 | ja | OK, 39.5 mm Luft | gewogen 137 g, Höhe angenommen 18
10 | Akku-Wanne (Druck) | 12.0 | 77.6 | 146.9 | -33.8 | 33.8 | 0.0 | 10.0 | 112.2 | 0.0 | 5.0 | 30.5 | 35.5 | 37.6 | ja | OK, 49.5 mm Luft | geschätzt
11 | Motortreiber MDD3A | 14.0 | 16.0 | 64.5 | -74.2 | -31.8 | 5.0 | 18.6 | 40.2 | -53.0 | 11.8 | 37.3 | 44.1 | 31.8 | ja | OK, 40.9 mm Luft | gewogen 14 g, auf Abstandshülsen 5 mm
12 | Abstandshülsen MDD3A (4 × M3 × 5) | 4.0 | 19.0 | 61.5 | -72.0 | -34.0 | 0.0 | 5.0 | 40.2 | -53.0 | 2.5 | 28.0 | 30.5 | 34.0 | ja | OK, 54.5 mm Luft | geschätzt, Messing oder Nylon
13 | Bedienpult mit Wippschalter (Start) | 12.0 | 14.0 | 62.0 | 30.0 | 80.0 | 0.0 | 38.0 | 38.0 | 55.0 | 19.0 | 44.5 | 63.5 | 30.0 | ja | OK, 21.5 mm Luft | geschätzt, Druckteil. Schalter steckt im Akku-Gewicht
14 | Schalen-Podest (Druck) | 24.0 | 11.0 | 69.0 | -29.0 | 29.0 | 0.0 | 67.2 | 40.0 | 0.0 | 33.6 | 59.1 | 92.7 | 0.0 | nein | Halter der Schale | geschätzt, Fuß Ø58, Rohr Ø36, Kopf Ø62 mit 6 Laschenlöchern. Oberhalb 85 mm nur Rohr Ø36 und Kopf Ø62, ganz unter der Schale verdeckt.
15 | Schale mit Ball | 26.0 | -11.0 | 91.0 | -51.0 | 51.0 | 67.2 | 79.5 | 40.0 | 0.0 | 73.3 | 98.8 | 105.0 | 0.0 | nein | Halter der Schale | gewogen 26 g, Höhe 12,3 noch messen
16 | Kugelrolle Pololu 955 | 30.0 | 140.0 | 160.0 | -11.0 | 11.0 | -25.5 | -5.0 | 150.0 | 0.0 | -15.2 | 10.2 | 20.5 | 100.0 | ja | OK, 64.5 mm Luft | gewogen 30 g
17 | Ultraschall vorne | 6.0 | 158.0 | 173.2 | -23.0 | 23.0 | 15.8 | 36.2 | 165.6 | 0.0 | 26.0 | 51.5 | 61.8 | 118.0 | ja | OK, 23.3 mm Luft | gewogen 6 g
18 | Ultraschall links | 6.0 | 66.0 | 112.0 | 73.0 | 88.2 | 14.2 | 34.8 | 89.0 | 80.6 | 24.5 | 50.0 | 60.2 | 77.5 | ja | OK, 24.8 mm Luft | gewogen 6 g
19 | Ultraschall rechts | 6.0 | 66.0 | 112.0 | -88.2 | -73.0 | 14.2 | 34.8 | 89.0 | -80.6 | 24.5 | 50.0 | 60.2 | 77.5 | ja | OK, 24.8 mm Luft | gewogen 6 g
20 | Sensorhalter (3 Stück, Druck) | 15.0 | 66.0 | 165.0 | -30.0 | 30.0 | 0.0 | 40.0 | 115.5 | 0.0 | 20.0 | 45.5 | 65.5 | 26.0 | ja | OK, 19.5 mm Luft | geschätzt, verteilt
21 | Stoßschalter Marquardt 1115 | 11.0 | 155.0 | 177.6 | -15.0 | 15.0 | 0.0 | 12.0 | 166.3 | 0.0 | 6.0 | 31.5 | 37.5 | 115.0 | ja | OK, 47.5 mm Luft | gewogen 11 g
22 | Stoßfänger-Bügel (Druck) | 8.0 | 148.0 | 182.0 | -74.0 | 74.0 | 0.0 | 12.0 | 165.0 | 0.0 | 6.0 | 31.5 | 37.5 | 108.0 | ja | OK, 47.5 mm Luft | geschätzt, PLA 2,4 mm
23 | Kabel, Schrauben, Muttern | 45.0 | -60.0 | 150.0 | -60.0 | 60.0 | 0.0 | 20.0 | 45.0 | 0.0 | 10.0 | 35.5 | 45.5 | 0.0 | ja | OK, 39.5 mm Luft | geschätzt: 25 Schrauben + Kabel
24 | Haube Batmobil (Masse nach dem Druck eintragen) | 0.0 | -88.0 | 170.0 | -88.0 | 88.0 | 0.0 | 59.5 | 41.0 | 0.0 | 29.8 | 55.2 | 85.0 | 0.0 | ja | OK, 0.0 mm Luft | Platzhalter: höchstens bis 85 mm über Boden
 | Summe | 849.4
 | Verstöße gegen den Freiraum | 0
 | So benutzt ihr das Blatt: Verschiebt ihr ein Bauteil, ändert die blauen von/bis-Werte. Spalte Freiraum und das Blatt Schwerpunkt V2 rechnen sofort neu.

Sheet: Grenzen
Grenzen und Rechenwerte für die Platte
Gelb = hier eintragen. Rest rechnet sich.
Was | Wert | Einheit | Herkunft | Hinweis
Roboter max. Länge × Breite × Höhe | 400 | mm | Regeln 3 | Im Stillstand gemessen.
Bahnbreite | 1500 | mm | Zeichnung Regeln | Start mittig, also 750 mm von Robotermitte bis zur Bande.
Höhe der Bande | 100 | mm | Regeln 2 | Seitensensoren tief setzen, Mitte 40 bis 60 mm über Boden.
Schale Ø am Rand | 102 | mm | gemessen
Freiraum um die Schale, Ø | 262 | mm | Regeln 4: 80 mm um den Rand | In diesem Kreis darf ab 20 mm unter dem Schalenrand nichts vom Roboter sein.
Folge daraus |  |  |  | Der Kreis ist breiter als die Platte. Also muss alles andere mindestens 20 mm tiefer liegen als der Schalenrand. Die Schale gehört nach oben.
Radachse über Boden | 40 | mm | Rad Ø80 / 2
Plattenoberseite über Boden | 25.5 | mm | Achse − 14,5 (Pololu-Winkel) | Gilt, wenn die Motoren oben auf der Platte sitzen.
Plattenstärke | 5 | mm | Sperrholz
Plattenunterseite über Boden | 20.5 | mm | berechnet | So hoch muss die Kugelrolle sein.
Kugelrolle ohne Spacer | 20.8 | mm | Pololu #955
Abweichung Kugelrolle | 0.3 | mm | berechnet | 0,3 mm, passt ohne Spacer.
Gewicht Sperrholz pro cm² | 0.36 | g/cm² | alte Platte
Neue Platte Länge | 200 | mm | Eingabe | Zum Ausprobieren ändern.
Neue Platte Breite | 150 | mm | Eingabe
Gewicht neue Platte | 106.5882353 | g | berechnet | Löcher und Aussparungen machen sie leichter.
Roboter gesamt mit neuer Platte | 663.5882353 | g | berechnet | Ohne Kleinteile und Druckhalter.

Sheet: Schwerpunkt V2
Grundplatte V2: Schwerpunkt, Kippen, Grenzwerte für den Code
Gelb = hier eintragen. Rest rechnet sich. Alle Werte aus dem Blatt Lage V2.
Was | Wert | Einheit | Formel / Herkunft
Schwerpunkt
Gesamtmasse | 849.4 | g | Summe aller Bauteile
Schwerpunkt x | 40.9 | mm | Σ(m·x) / Σm, vor der Radachse
Schwerpunkt y | -0.3 | mm | Σ(m·y) / Σm, ideal 0
Schwerpunkt z (ab Plattenoberseite) | 11.2 | mm | Σ(m·z) / Σm
Schwerpunkt über Boden | 36.7 | mm | für die Kipprechnung
Abstand Schalenmitte zum Schwerpunkt (x) | -0.9 | mm | klein halten
Kippen und Haftung
Kugelrolle x (Aufstandspunkt) | 150.0 | mm | Lochmitte Kugelrolle
Haftbeiwert Rad auf Bahn (Annahme) | 0.60 |  | Gummi auf Holz/Kunststoff, eher vorsichtig
g | 9.81 | m/s²
Last auf den Antriebsrädern | 72.73424378% |  | (x_Kugel − x_S) / x_Kugel. Über 60 % ist gut für Haftung und Encoder.
Kippen nach vorn ab Verzögerung | 29.14 | m/s² | g · (x_Kugel − x_S) / h_S
Kippen nach hinten ab Beschleunigung | 10.92 | m/s² | g · x_S / h_S
Räder rutschen ab | 4.28 | m/s² | µ · g · Lastanteil
Ball in der Schale
Kippwinkel, bei dem der Ball herausrollt | 10.0 | ° | Ann.: Neigung außen ca. 10°. Mit dem Kipptest messen und hier eintragen.
Ball rollt bei Dauerbeschleunigung heraus ab | 1.73 | m/s² | g · tan(Kippwinkel), ohne Schwingen gerechnet
Grenzwerte für den Code
a_max beschleunigen und bremsen | 0.30 | m/s² | Startwert, sicher in beiden Schalenmodellen der Simulation. Ist die Schale kegelig (Kipptest), gehen 0,8.
Sicherheitsfaktor zum statischen Grenzwert | 5.77 |  | soll ≥ 2 sein, weil der Ball nachschwingt
Ruckzeit (Rampe der Beschleunigung) | 0.30 | s | a nicht springen lassen, sondern in dieser Zeit hochfahren
v_max | 0.70 | m/s | Reisegeschwindigkeit
v_kriech an der Endwand | 0.05 | m/s | letzte 3 cm vor der Wand
Pause an der Endwand | 1.00 | s | Ball beruhigen, bevor die Rückfahrt beschleunigt
Regeltakt | 20.0 | ms | Schleifenzeit im Code
Raddurchmesser | 80.0 | mm | Pololu 80 × 10
Geschwindigkeitsänderung pro Takt | 6.0 | mm/s | a_max · Takt
… in Umdrehungen pro Minute pro Takt | 1.4 | U/min | für eine Drehzahlregelung
Weg zum Beschleunigen auf v_max | 0.92 | m | v²/(2a) plus Anteil der Rampe
Bremsen beginnen bei Abstand zur Wand | 0.95 | m | Bremsweg plus 3 cm Kriechstrecke, ab Stoßfänger gemessen
Fahrzeit grob (hin und zurück) | 12.58 | s | 4 Rampen + 2 × Reisestrecke + Kriechen + Pause. Grobe Obergrenze.
