trpbabos-jpg/Tech-pioneers-/bom/datenblaetter/eneloop_bk-3mcde_daten.jpg

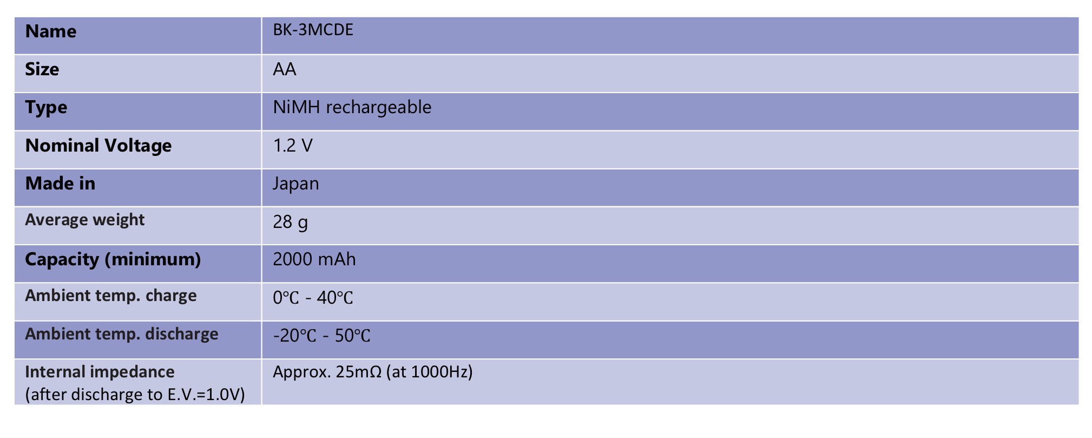
bom/datenblaetter/eneloop_bk-3mcde_daten.jpg
