trpbabos-jpg/Tech-pioneers-/bom/datenblaetter/esp32-pico_wlan-strom_tabelle19.jpg

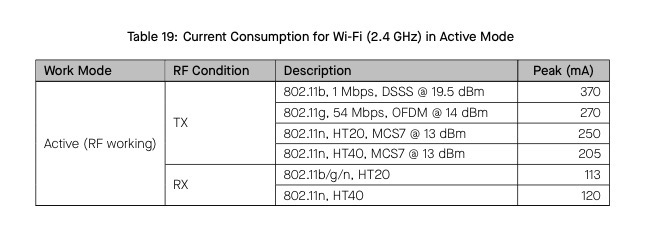
bom/datenblaetter/esp32-pico_wlan-strom_tabelle19.jpg
