trpbabos-jpg/Tech-pioneers-/bom/datenblaetter/fit0520_motor_daten.jpg

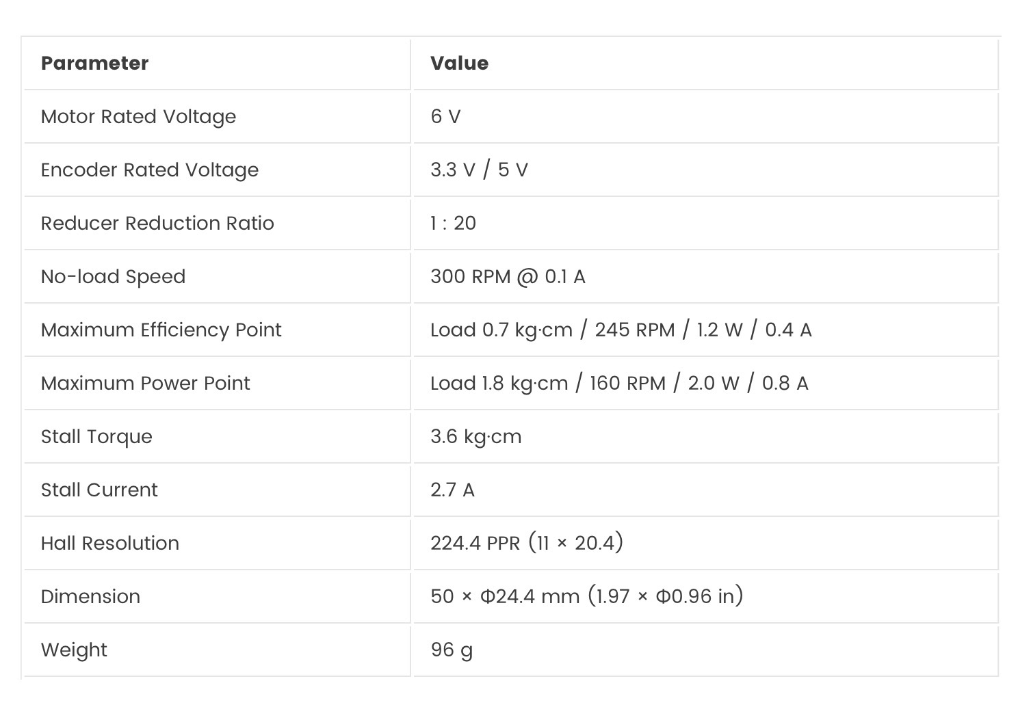
bom/datenblaetter/fit0520_motor_daten.jpg
