trpbabos-jpg/Tech-pioneers-/bom/datenblaetter/mdd3a_platine.jpg

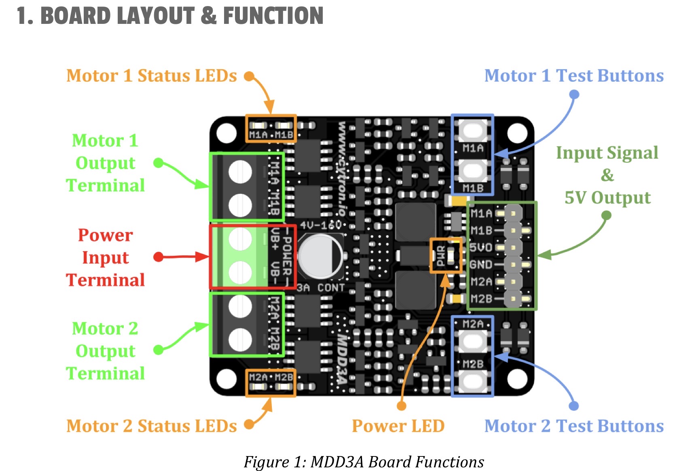
bom/datenblaetter/mdd3a_platine.jpg
