trpbabos-jpg/Tech-pioneers-/cad/Grundplatte_V2_Laser.dxf

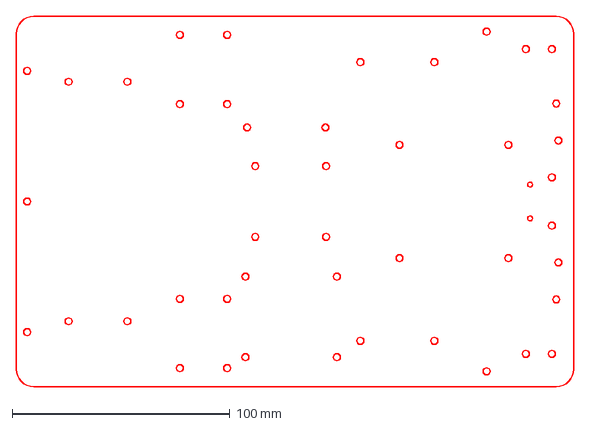
[picture p39: CAD file, 2026-11-06]
cad/Grundplatte_V2_Laser.dxf
256.0 x 170.0 mm
