trpbabos-jpg/Tech-pioneers-/code/tests/README.md

# Testprogramme

Kleine Programme für einzelne Bauteile, z. B. `test_led.py`, `test_motor_links.py`, `test_ultraschall_vorne.py`, `test_encoder.py`.
Nicht löschen: Nach jeder Änderung am Aufbau laufen dieselben Tests noch einmal.

## Vorhandene Tests

| Datei | Bauteil | Pins damals |
| --- | --- | --- |
| `2026-10-20_test_motor.py` | Motor 1 am MDD3A, PWM mit Rampe | GPIO32 / GPIO33 |
| `2026-10-20_test_ultraschall_led.py` | HC-SR04 mit Mittelwert aus 5 Messungen, LED unter 30 cm | Trig 26, Echo 25, LED 2 |
| `2026-10-23_test_encoder.py` | Encoder Motor 1, zählt Impulse mit Richtung | A 13, B 14 |

Die Dateien haben noch die Pins vom Tag im Dateinamen. Seit dem Umbau am 29.10. stimmen sie nicht mehr: vor dem Testen die Pins oben im Programm an `elektronik/pinbelegung.md` anpassen.

## Tests nach dem Umbau am 29.10. (Pins passen zum Steckplan vom 29.10.)

| Datei | Wofür |
| --- | --- |
| `2026-10-29_motor_test.py` | prüft, ob beide Räder bei positiven Werten vorwärts drehen |
| `2026-10-29_kalibrieren.py` | Teil 1: Anlaufschwelle (in der Luft). Teil 2: Vmax vor der Wand (auf dem Boden, `TEIL2_VMAX = True`) |
| `2026-10-29_drehzahl_test.py` | U/min links und rechts bei 15 bis 100 %, daraus `FAKTOR_LINKS` |
| `2026-10-29_bremsen_test.py` | sanftes Bremsen vor der Wand ohne Stoßschalter, Ziel 15 cm |

Ergebnisse stehen in `doku/messwerte.md`. Hinweis: Die aktuelle `main.py` hat seit dem 30.10. nur noch einen `ANLAUF` und keine `RICHTUNG_`-Werte, die Tests rechnen noch mit den Werten vom 29.10.
