trpbabos-jpg/Tech-pioneers-/doku/testtabelle.md

# Testtabelle

Vor jedem Test aufschreiben, woran man den Erfolg erkennt (Kap. 8). Nach jeder Änderung dieselben Tests wiederholen, dann fallen Rückschritte sofort auf.

| Datum | Wer | Test | Durchführung | Erwartung | Ergebnis | ok? |
| --- | --- | --- | --- | --- | --- | --- |
| | | LED | Blink-Programm | LED blinkt im Sekundentakt | | |
| | | Taster | Taster drücken, Ausgabe beobachten | „gedrückt“ erscheint genau einmal | | |
| | | Motor links | Roboter aufbocken, Motor ansteuern | Rad dreht vorwärts, dann rückwärts | | |
| | | Motor rechts | Roboter aufbocken, Motor ansteuern | Rad dreht vorwärts, dann rückwärts | | |
| | | Encoder | Rad eine Umdrehung von Hand drehen | Zählerstand passt zu den Impulsen pro Umdrehung | | |
| | | Ultraschall vorne | Wand in 20 cm und 50 cm (Lineal) | Messwerte auf ±1 cm genau | | |
| | | Ultraschall links | Wand in 20 cm und 50 cm (Lineal) | Messwerte auf ±1 cm genau | | |
| | | Ultraschall rechts | Wand in 20 cm und 50 cm (Lineal) | Messwerte auf ±1 cm genau | | |
| | | Geradeausfahrt | 200 cm fahren, seitliche Abweichung messen (3 Mal) | Abweichung unter 5 cm | | |
| | | Abbremsen | auf Wand zufahren | stoppt sanft vor der Wand, Ball bleibt liegen | | |
| | | Geschwindigkeit | 200 cm fahren, Zeit stoppen (3 Mal) | Durchschnittsgeschwindigkeit notiert | | |
