trpbabos-jpg/Tech-pioneers-/doku/praesentationen/2026-10-23_encoder-pins.pdf

# Encoder: Warum diese vier Pins

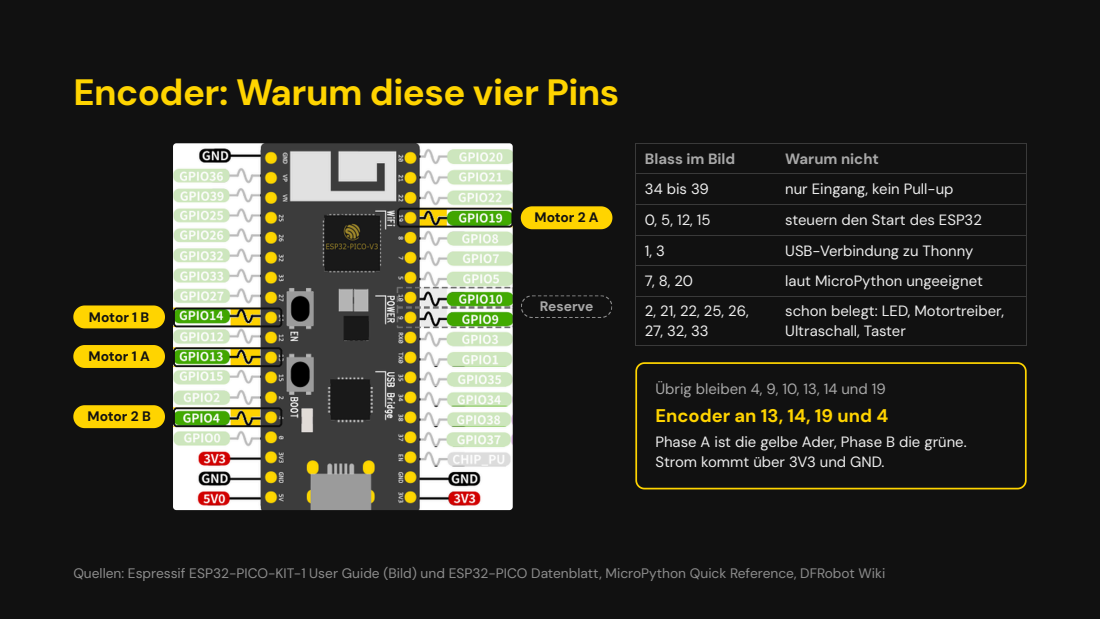
[picture p40: page 1]
Motor 1 B; Motor 1 A; Motor 2 B; Motor 2 A; Reserve; Blass im Bild; Warum nicht; 34 bis 39; nur Eingang, kein Pull-up; steuern den Start des ESP32; USB-Verbindung zu Thonny; laut MicroPython ungeeignet

schon belegt: LED, Motortreiber,
Ultraschall, Taster

Übrig bleiben 4, 9, 10, 13, 14 und 19
Encoder an 13, 14, 19 und 4
Phase A ist die gelbe Ader, Phase B die grüne.
Strom kommt über 3V3 und GND.

Quellen: Espressif ESP32-PICO-KIT-1 User Guide (Bild) und ESP32-PICO Datenblatt, MicroPython Quick Reference, DFRobot Wiki

# Belege: Das sagen die Hersteller

### 34 bis 39: kein interner Pull-up

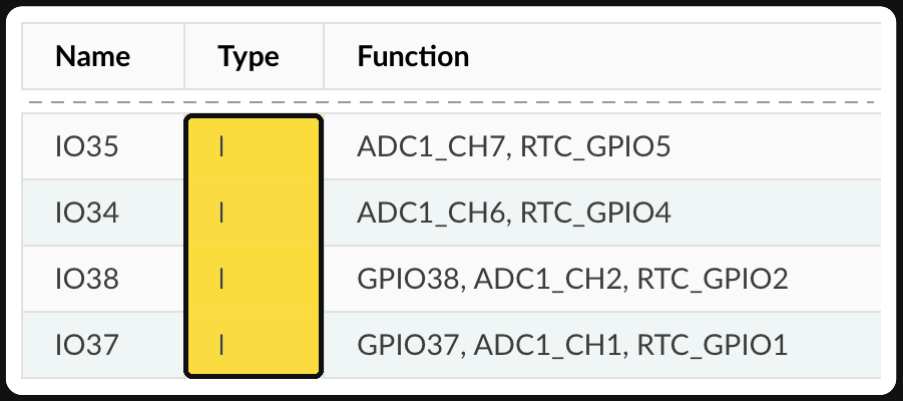
[picture p41: figure]

Espressif Pin-Tabelle: Type I = nur Eingang, laut Datenblatt ohne Pull-up

### 0, 5, 12, 15: steuern den Start

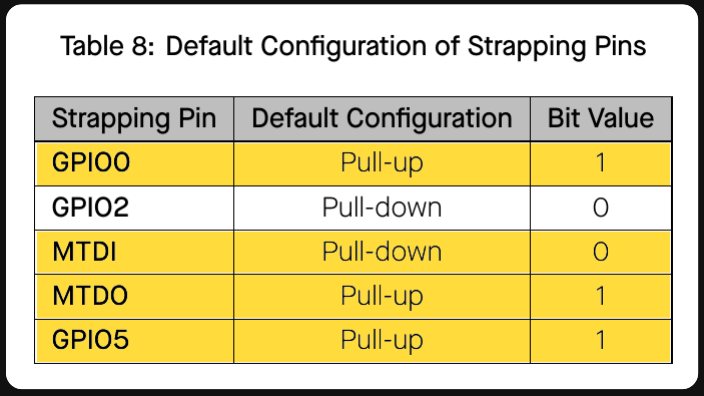
[picture p42: figure]

Datenblatt Table 8 · MTDI = GPIO12, MTDO = GPIO15

### 1 und 3: Verbindung zu Thonny

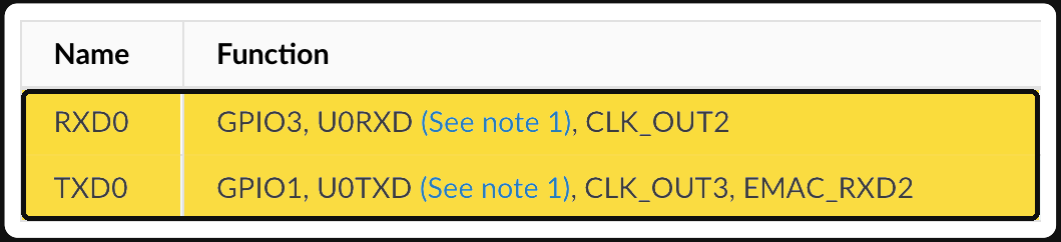
[picture p43: figure]

Note 1: „connected to the USB bridge chip on the board“

### 7, 8, 20: laut MicroPython ungeeignet

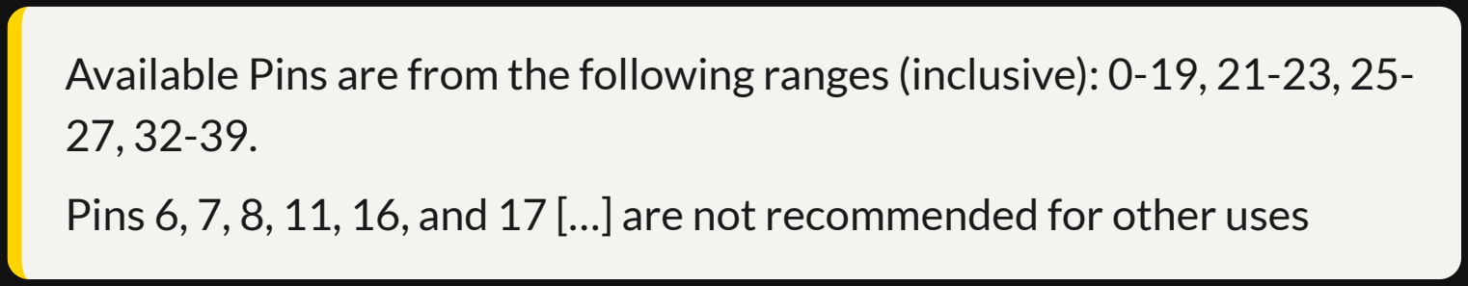
[picture p44: figure]

Available Pins are from the following ranges (inclusive): 0-19, 21-23, 25-

Pins 6, 7, 8, 11, 16, and 17 […] are not recommended for other uses

MicroPython Quick Reference für den ESP32

Quellen: docs.espressif.com, ESP32-PICO-KIT-1 User Guide; Espressif ESP32-PICO Datenblatt v1.4; docs.micropython.org
