trpbabos-jpg/Tech-pioneers-/(commit log)

2026-11-06 Ordnerstruktur, README, Materialliste und Testtabelle anlegen
    [materialliste.csv]
2026-11-06 Bisherigen Projektstand nachtragen: Pinbelegung mit Verlauf, Einstellwerte, Messwerte, Änderungsverlauf, Grundplatte v2, Kit-Inhalt
    [materialliste.csv]
2026-11-06 Pitch-Folien, Datenblatt-Auszüge und ECHO-Formskizze hinzugefügt
    - doku/praesentationen/2026-10-16_pitch.pdf: Folien vom Pitch am 16.10.
    - bom/datenblaetter/: Auszüge aus den Datenblättern von ESP32, Motor, MDD3A, HC-SR04 und Eneloop mit Quellen
    - cad/skizzen/: erste Formskizze ECHO in der Draufsicht
    - READMEs und Änderungsverlauf verweisen auf die neuen Ordner
2026-11-06 Folien vom 23.10., 30.10. und 06.11. als PDF hinzugefügt
    - doku/praesentationen/: Encoder-Pins, Frankenstein-Modell und Encoder, Weekly Closing KW 45
    - Änderungsverlauf verweist auf die Folien
2026-11-06 CAD Grundplatte v2: Laserdatei, Zeichnung und Maßtabelle
    [Grundplatte_Masse_Gewicht_V2.xlsx, Grundplatte_V2_Laser.dxf]
2026-11-06 Zeichnung Grundplatte v1 und Steckplan vom 29.10. ergänzt
2026-11-07 Testprogramme Motor, Ultraschall und Encoder (Stand 20. und 23.10.) ergänzt
2026-11-07 Code-Stände v1 bis v3, aktuelle main.py und Tests vom 29.10. hochgeladen
    Einstellwerte, Messwerte (Kalibrierung 29.10.), Test-Übersicht und Änderungsverlauf ergänzt.
2026-11-10 Zeichnungen Grundplatte v1 und v2 entfernt
2026-11-13 Stand 13.11.: Echo-Halterung montiert, Elektronik verkabelt, CAD-Baugruppe teilweise
2026-11-13 CAD-Screenshots vom 13.11. nach fotos/2026-11-13_cad_baugruppe verschoben
2026-11-13 Materialliste als Tabelle (Markdown) statt CSV, Spaltenfehler in Zeile Ultraschall behoben
    [materialliste.csv]
